dialogiot/Weatherguru/Design files/Com module/NBIoT/Weather Station v2.2-wihtparts.brd

## EAGLE design Design files/Com module/NBIoT/Weather Station v2.2-wihtparts.brd (2019-03-18)

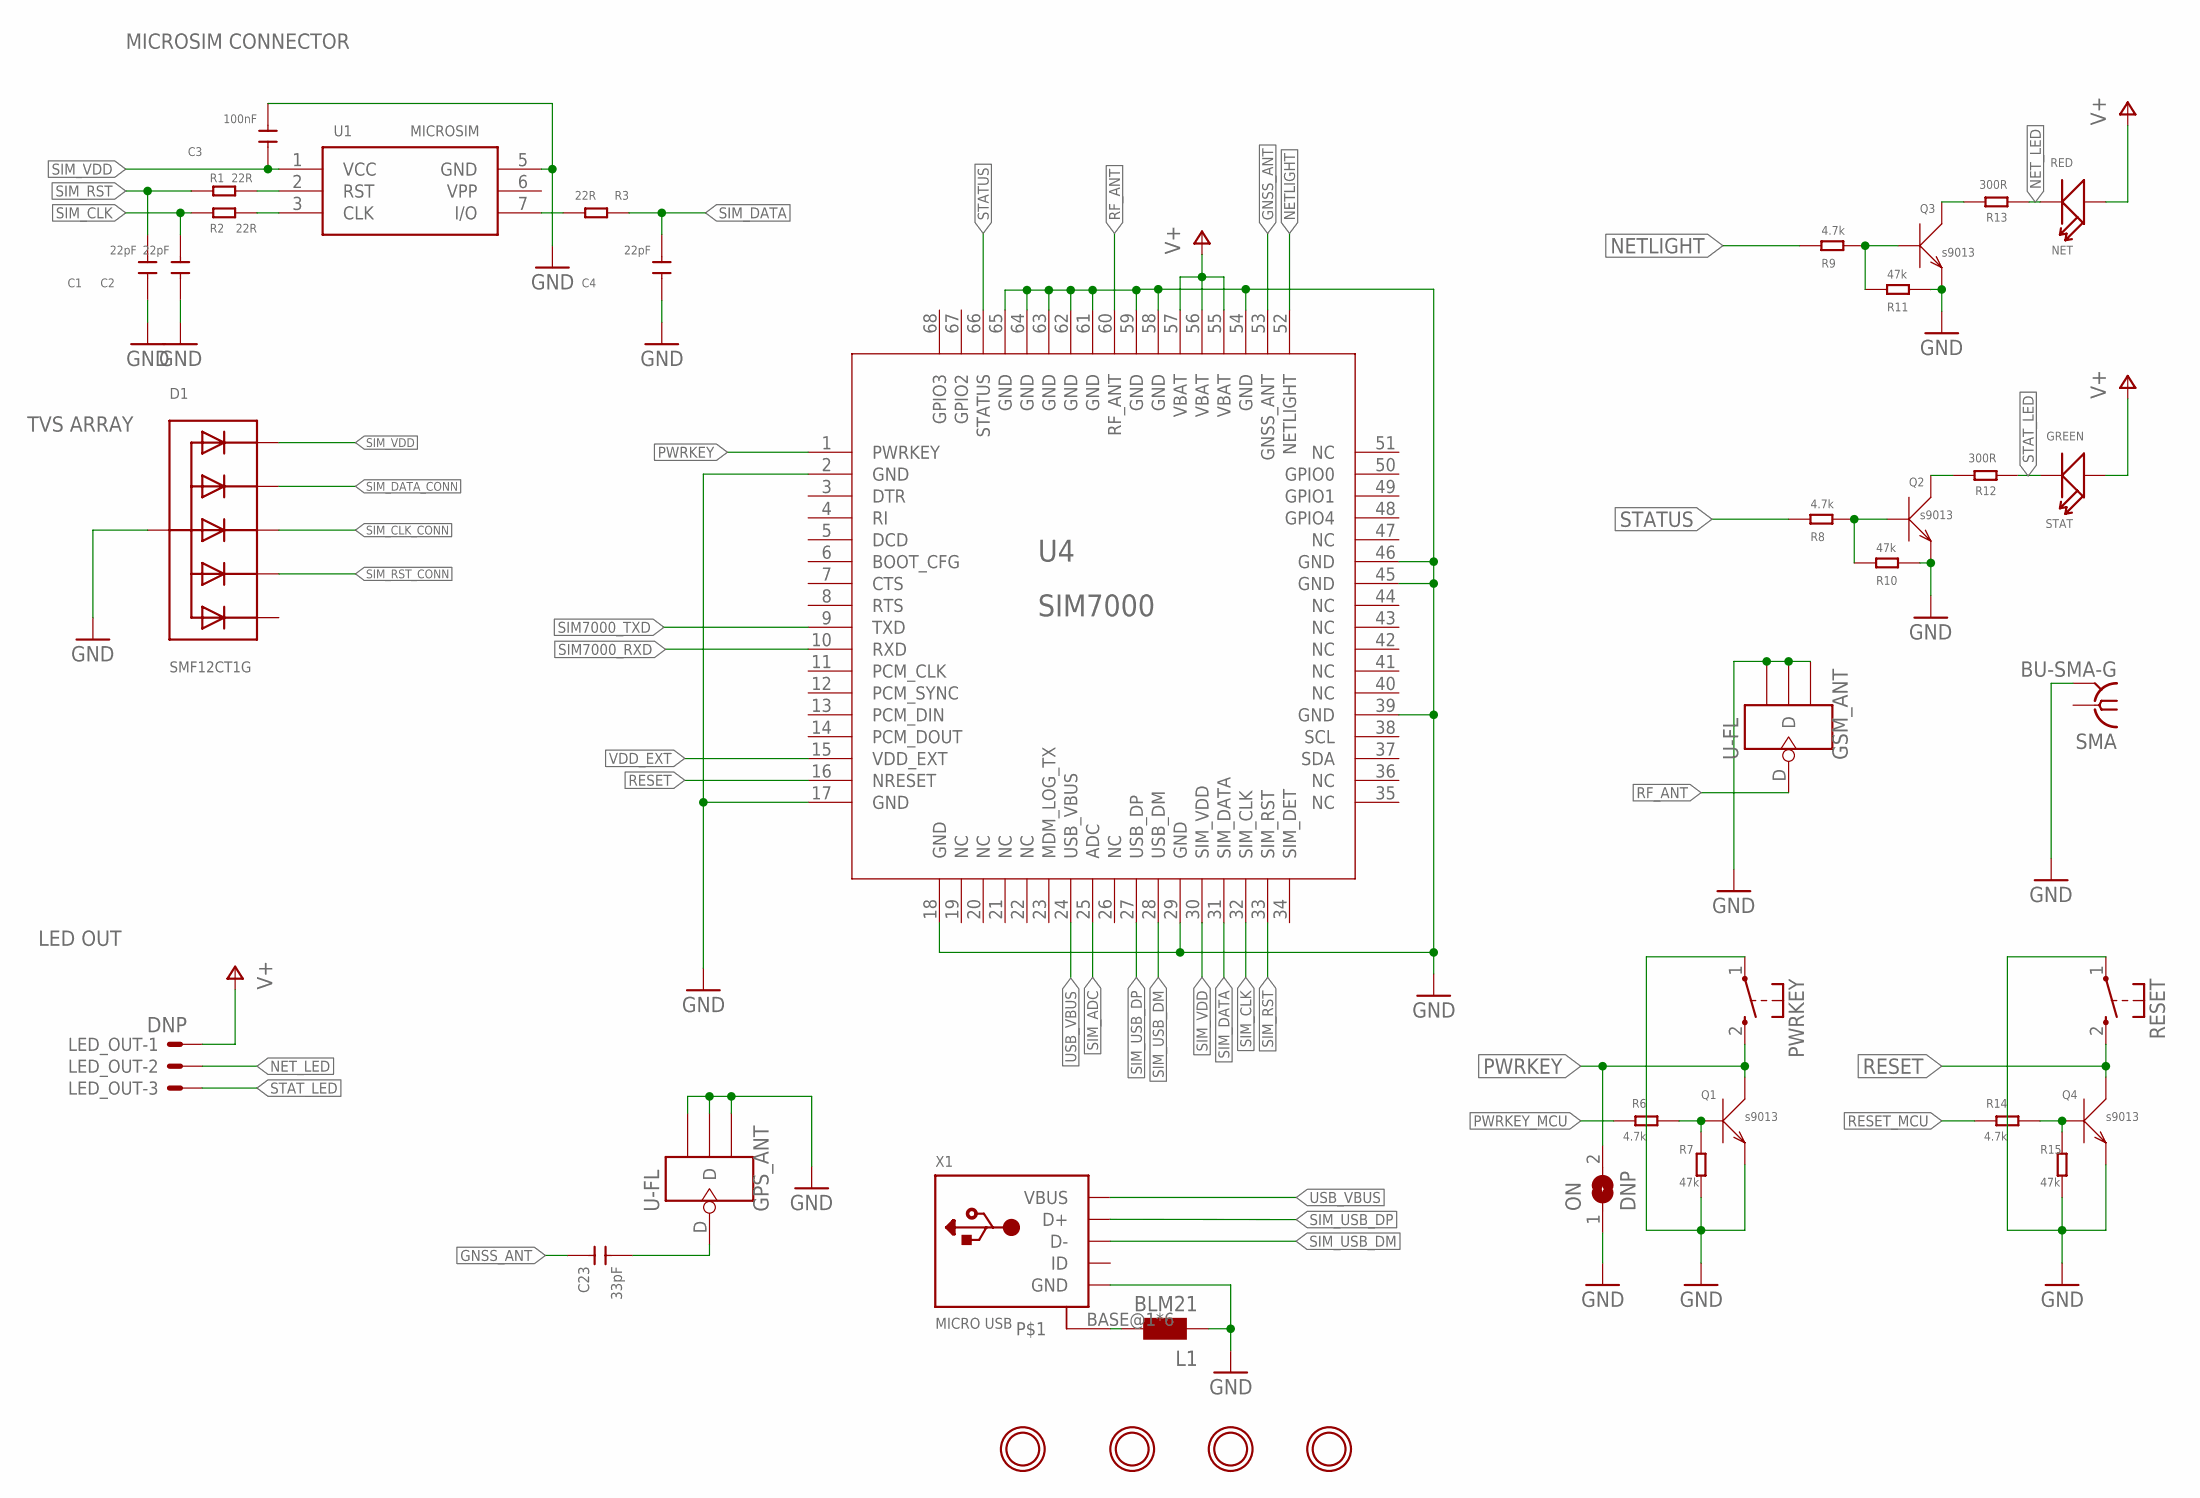
[picture p14: schematic Weather Station v2.2-wihtparts.sch, sheet 1]

Parts:
$H1, $H2, $H3, $H4: DNP; MOUNTINGHOLE_3.0_PLATEDTHIN
C1, C2, C4: 22pF; 0805; MPN C0402C220J5GACTU
C3: 100nF; 0805; MPN 08053G105ZAT2A
C23: 33pF; 0805
D1: SMF12CT1G; SOT363; MPN SMF12CT1G
GPS_ANT: U-FL; 4P-U-FL
GSM_ANT: U-FL; 4P-U-FL; MPN U.FL-R-SMT(01)
L1: BLM21; 0805; MPN BLM21AG121SN1D
LED_OUT: DNP; JST-XH-03-WIRE
NET: RED; LED-2P-2.54-3MM; MPN 5988110107F
ON: DNP; SOLDERJUMPER_REFLOW
PWRKEY: KSS-2EG4430
Q1, Q2, Q3, Q4: s9013; SOT23; MPN DTC143TKAT146.
R1, R2, R3: 22R; 0805; MPN CRM0805-FX-51R0ELF
R6, R8, R9, R14: 4.7k; 0805; MPN MCWF08P4701FTL
R7, R10, R11, R15: 47k; 0805; MPN CRCW080547K0FKEA
R12, R13: 300R; 0805; MPN ERA-6AEB301V
RESET: KSS-2EG4430
SMA: BU-SMA-G; MPN 19-49-5-TGG
STAT: GREEN; LED-2P-2.54-3MM; MPN SML-LX0805SUGC-TR
U1: MICROSIM
U4: SIM7000
X1: MICRO USB; 4UCONN_20329_V2; MPN 10118193-0001LF

Connections:
GND: C1.1, C2.1, C3.2, C4.1, D1.2 (A), GPS_ANT.GND1, GPS_ANT.GND2, GPS_ANT.GND3, GSM_ANT.GND1, GSM_ANT.GND2, GSM_ANT.GND3, L1.1, ON.1, PWRKEY.1, Q1.2 (E), Q2.2 (E), Q3.2 (E), Q4.2 (E), R7.2, R10.2, R11.2, R15.2, RESET.1, SMA.2, SMA.3 (2), SMA.4 (2), SMA.5 (2), U1.5 (GND), U4.2 (GND), U4.17 (GND), U4.18 (GND), U4.29 (GND), U4.39 (GND), U4.45 (GND), U4.46 (GND), U4.54 (GND), U4.58 (GND), U4.59 (GND), U4.61 (GND), U4.62 (GND), U4.63 (GND), U4.64 (GND), U4.65 (GND), X1.GND; also elsewhere on the board
GNSS_ANT: C23.2, U4.53 (GNSS_ANT)
GPIO2: U4.67 (GPIO2)
GPIO3: U4.68 (GPIO3)
unnamed: Q4.1 (B), R14.2, R15.1
unnamed: Q2.3 (C), R12.2
unnamed: Q2.1 (B), R8.2, R10.1
unnamed: Q3.3 (C), R13.2
unnamed: Q3.1 (B), R9.2, R11.1
unnamed: C23.1, GPS_ANT.D
unnamed: L1.2, X1.BASE@1, X1.BASE@2, X1.SPRT@1, X1.SPRT@2, X1.SPRT@3, X1.SPRT@4
unnamed: Q1.1 (B), R6.2, R7.1
NETLIGHT: R9.1, U4.52 (NETLIGHT)
NET_LED: LED_OUT.2, NET.K (-), R13.1
PWRKEY: ON.2, PWRKEY.2 (S), Q1.3 (C), U4.1 (PWRKEY)
PWRKEY_MCU: R6.1; also elsewhere on the board
RESET: Q4.3 (C), RESET.2 (S), U4.16 (NRESET)
RESET_MCU: R14.1; also elsewhere on the board
RF_ANT: GSM_ANT.D, U4.60 (RF_ANT)
SIM7000_RXD: U4.10 (RXD); also elsewhere on the board
SIM7000_TXD: U4.9 (TXD); also elsewhere on the board
SIM_ADC: U4.25 (ADC)
SIM_CLK: C2.2, R2.2, U4.32 (SIM_CLK)
SIM_CLK_CONN: D1.4 (C3), R2.1, U1.3 (CLK)
SIM_DATA: C4.2, R3.1, U4.31 (SIM_DATA)
SIM_DATA_CONN: D1.3 (C2), R3.2, U1.7 (I/O)
SIM_RST: C1.2, R1.2, U4.33 (SIM_RST)
SIM_RST_CONN: D1.5 (C4), R1.1, U1.2 (RST)
SIM_USB_DM: U4.28 (USB_DM), X1.D-
SIM_USB_DP: U4.27 (USB_DP), X1.D+
SIM_VDD: C3.1, D1.1 (C1), U1.1 (VCC), U4.30 (SIM_VDD)
STATUS: R8.1, U4.66 (STATUS)
STAT_LED: LED_OUT.3, R12.1, STAT.K (-)
USB_VBUS: U4.24 (USB_VBUS), X1.VBUS
V+: LED_OUT.1, NET.A (+), STAT.A (+), U4.55 (VBAT), U4.56 (VBAT), U4.57 (VBAT); also elsewhere on the board
VDD_EXT: U4.15 (VDD_EXT); also elsewhere on the board

Notes on the sheet:
TVS ARRAY
MICROSIM CONNECTOR
LED OUT

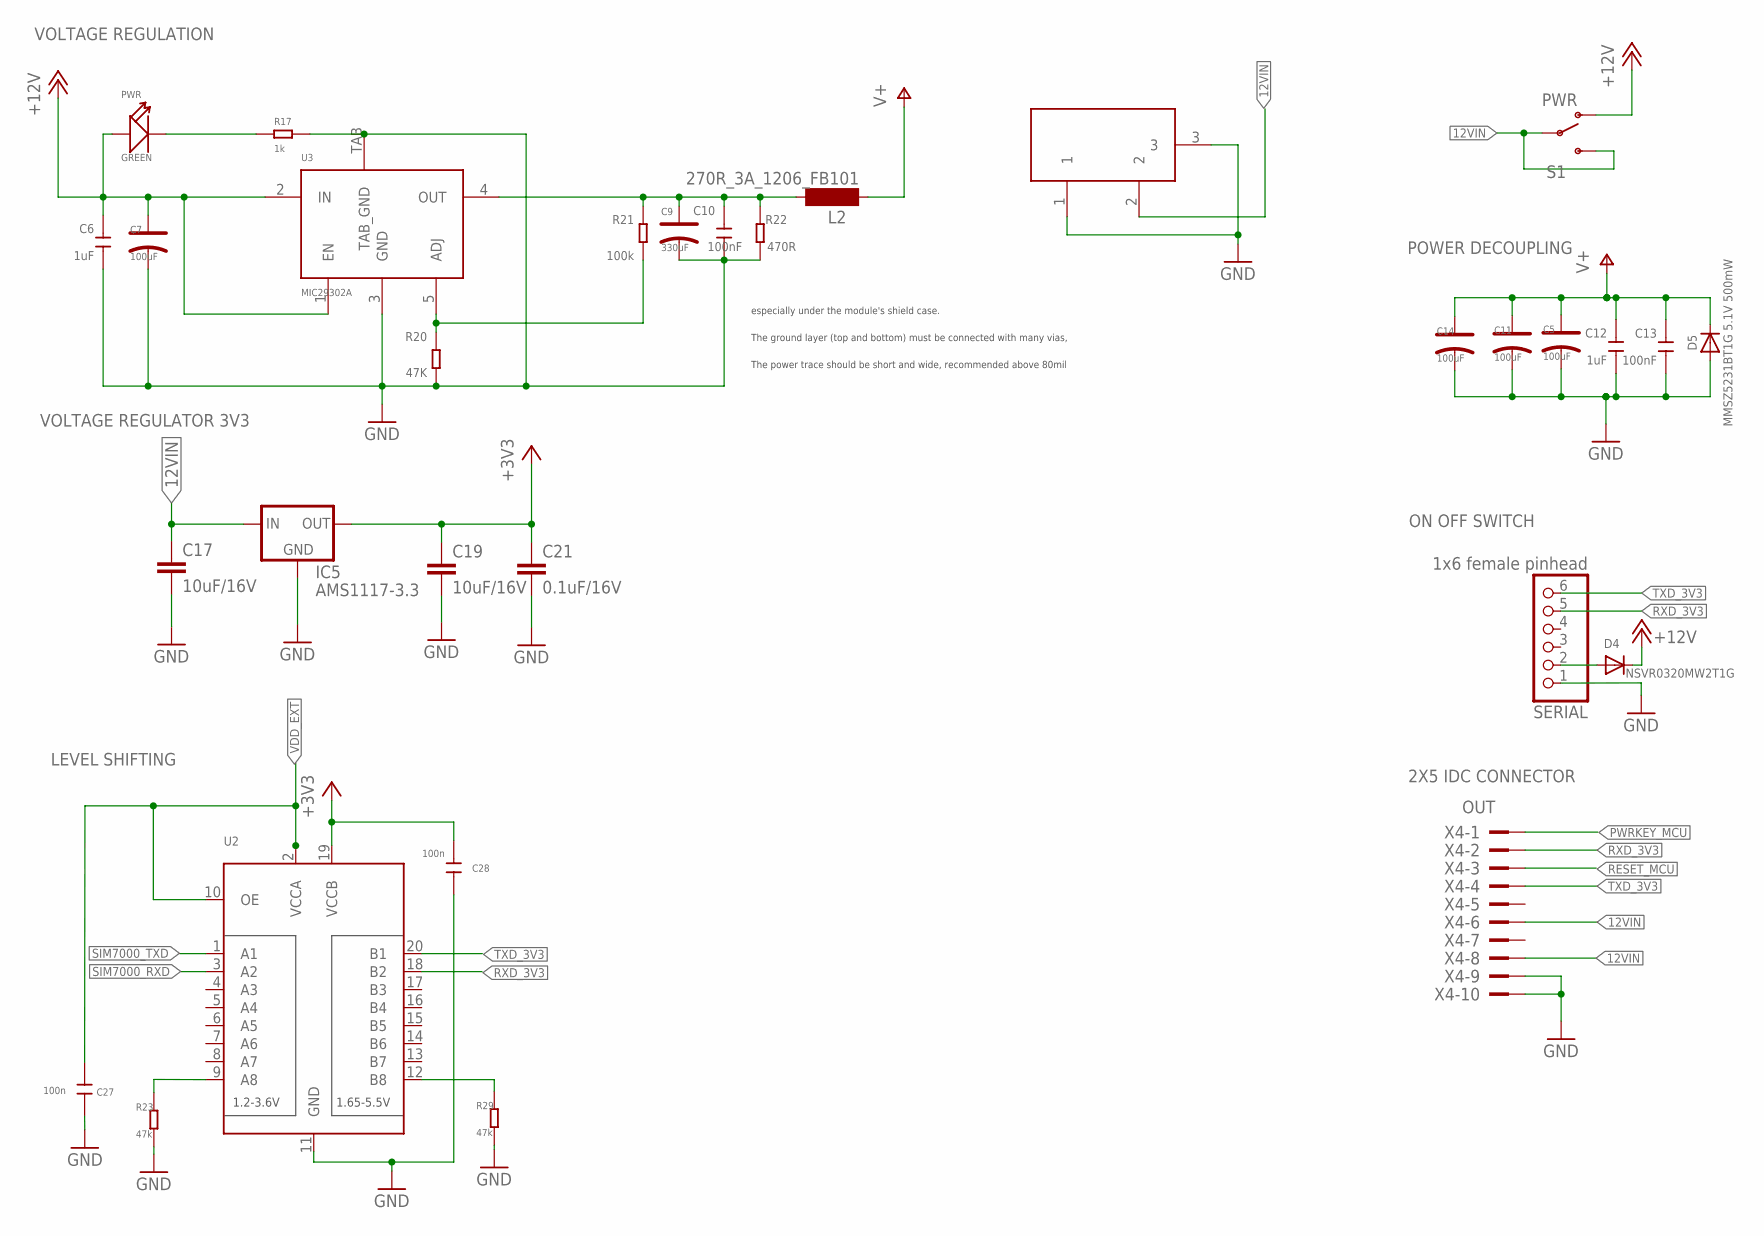
[picture p15: schematic Weather Station v2.2-wihtparts.sch, sheet 2]

Parts:
C5, C7, C11, C14: 100uF; AVX_D; MPN TCJD107M025R0055
C6: 1uF; 0805; MPN 08053G105ZAT2A
C8: DC21MMX; DC-21MM; MPN FC681478
C9: 330uF; AVX_D; MPN TCJE337M016R0050
C10: 100nF; 0805; MPN MC0805B104M160CT
C12: 1uF; 0805; MPN GRM21BF51C106ZE15L
C13: 100nF; 0805; MPN 08055A330JAT2A
C17, C19: 10uF/16V; C0805K
C21: 0.1uF/16V; C0805K
C27, C28: 100n; 0805
D4: NSVR0320MW2T1G; SOD-323; MPN NSVR0320MW2T1G
D5: MMSZ5231BT1G 5.1V 500mW; SOD-123; MPN MMSZ5231BT1G
IC5: AMS1117-3.3; SOT223
L2: 270R_3A_1206_FB101; SM-1206; MPN 742792121
PWR: GREEN; D0805; MPN SML-LX0805SUGC-TR
R17: 1k; 0805; MPN CRCW08051K00FKTA
R20: 47K; 0805; MPN CRCW080543K0JNEA.
R21: 100k; 0805; MPN CRCW0805100KJNEA
R22: 470R; 0805; MPN ERA-6AEB471V
R23, R29: 47k; 0805
S1: PWR; SWITCH-SPDT-CUSTOM; MPN EG1201
SERIAL: 1x6 female pinhead; 1X06
U2: TXB0108PWR; TSSOP20
U3: MIC29302A; TO-263A; MPN MIC29302WU-TR
X4: OUT; PAK100/2500-10; MPN 30310-6002HB

Connections:
12VIN: C8.2, C17.1, IC5.3 (IN), S1.2, S1.3 (S), X4.6, X4.8
+3V3: C19.1, C21.1, C28.2, IC5.2 (OUT), U2.19 (VCCB)
+12V: C6.2, C7.+, D4.C, PWR.+, S1.1 (O), U3.1 (EN), U3.2 (IN)
GND: C5.-, C6.1, C7.-, C8.1, C8.3, C9.-, C10.1, C11.-, C12.1, C13.1, C14.-, C17.2, C19.2, C21.2, C27.1, C28.1, D5.A, IC5.1 (GND), R17.2, R20.1, R22.1, R23.2, R29.2, SERIAL.1, U2.11 (GND), U3.3 (GND), U3.TAB (TAB_GND), X4.9, X4.10; also elsewhere on the board
unnamed: R20.2, R21.1, U3.5 (ADJ)
unnamed: R23.1, U2.9 (A8)
unnamed: D4.A, SERIAL.2
unnamed: R29.1, U2.12 (B8)
unnamed: PWR.-, R17.1
PWRKEY_MCU: X4.1; also elsewhere on the board
RESET_MCU: X4.3; also elsewhere on the board
RXD_3V3: SERIAL.5, U2.18 (B2), X4.2
SIM7000_RXD: U2.3 (A2); also elsewhere on the board
SIM7000_TXD: U2.1 (A1); also elsewhere on the board
TXD_3V3: SERIAL.6, U2.20 (B1), X4.4
V+: C5.+, C11.+, C12.2, C13.2, C14.+, D5.C, L2.1; also elsewhere on the board
VDD_EXT: C27.2, U2.2 (VCCA), U2.10 (OE); also elsewhere on the board
VOUT: C9.+, C10.2, L2.2, R21.2, R22.2, U3.4 (OUT)

Notes on the sheet:
The power trace should be short and wide, recommended above 80mil
The ground layer (top and bottom) must be connected with many vias,
especially under the module's shield case.
VOLTAGE REGULATION
ON OFF SWITCH
POWER DECOUPLING
LEVEL SHIFTING
2X5 IDC CONNECTOR
VOLTAGE REGULATOR 3V3

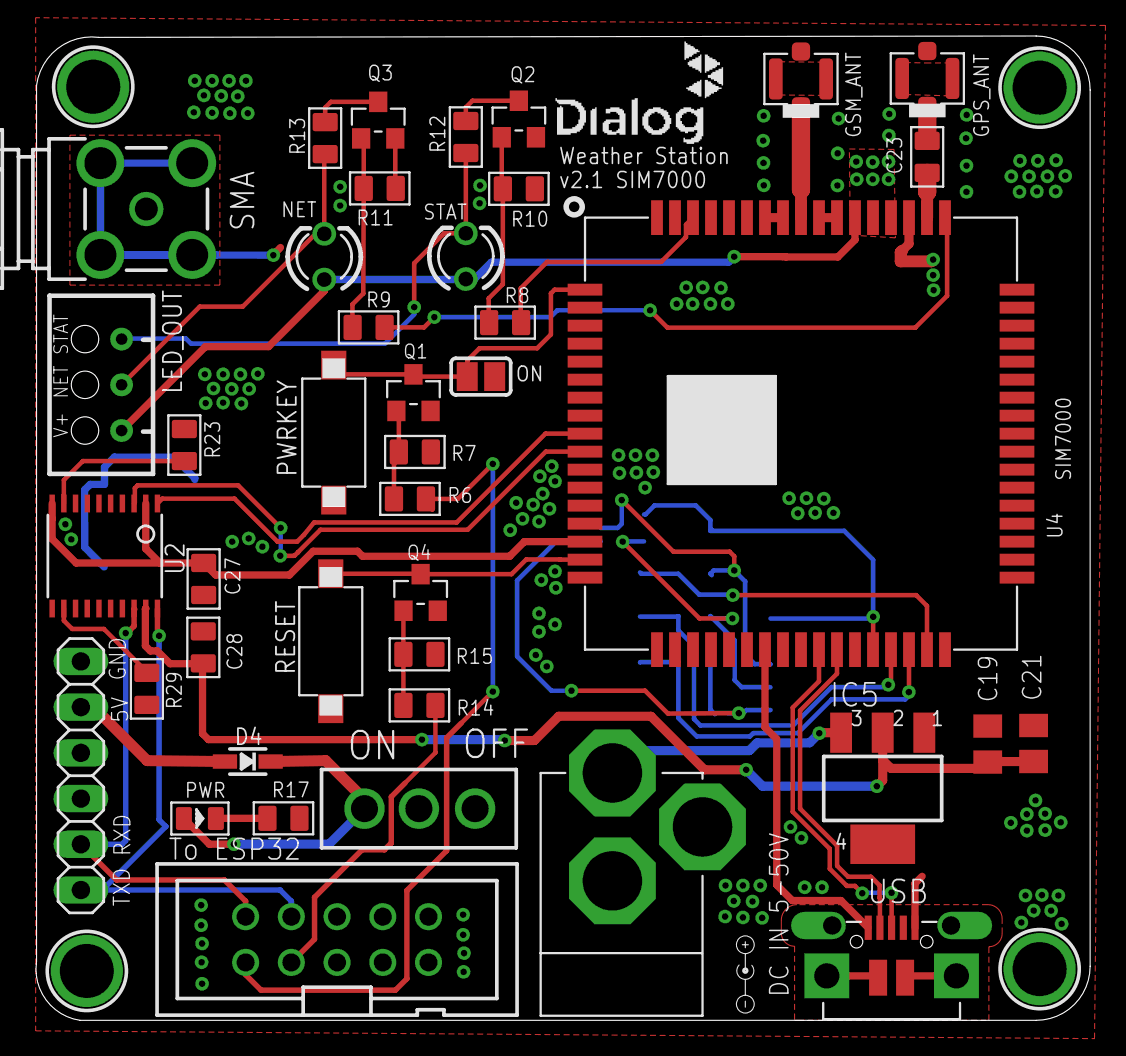
[picture p16: board Weather Station v2.2-wihtparts.brd from above]

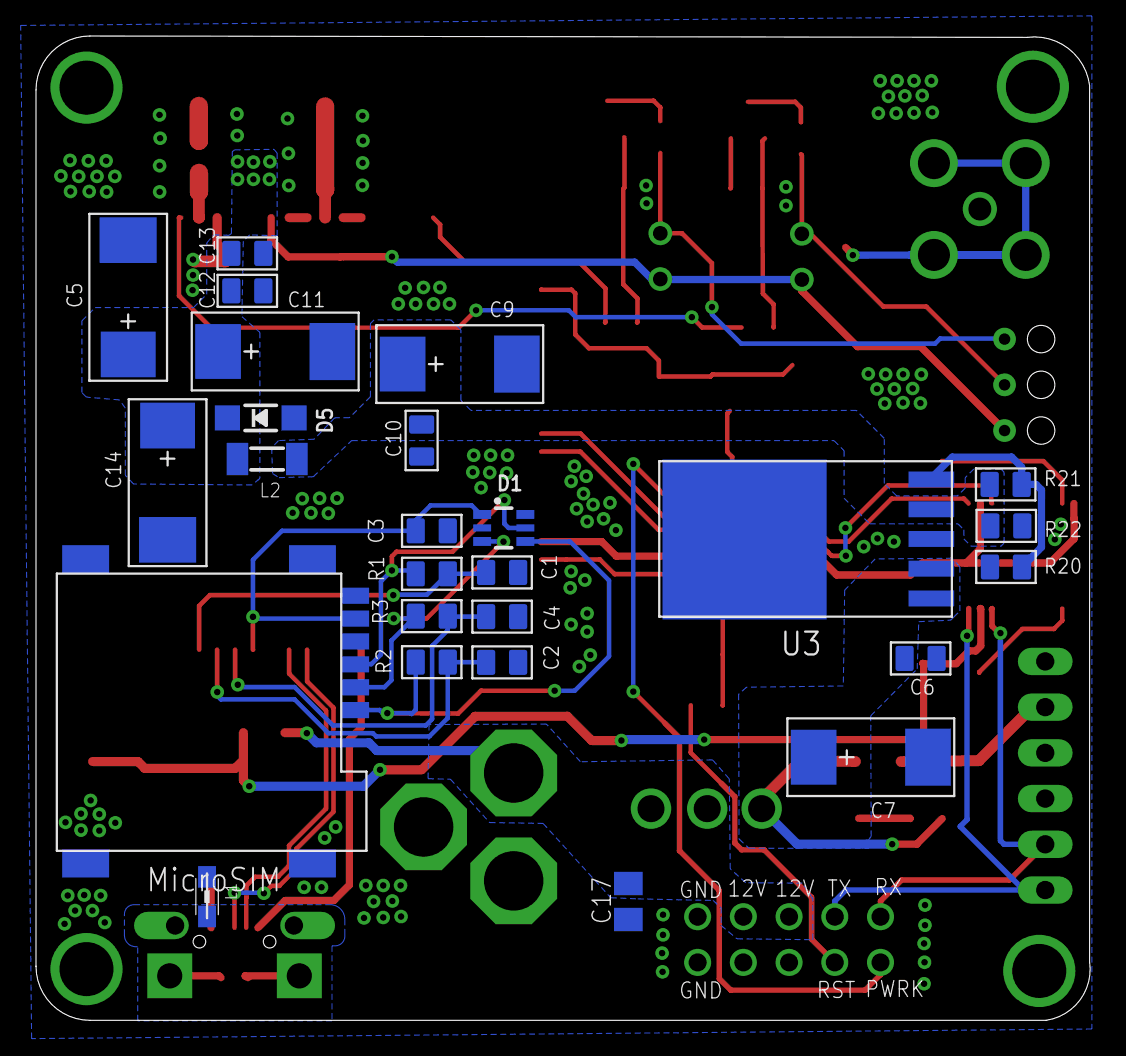
[picture p17: board Weather Station v2.2-wihtparts.brd from below]

Board: 2 copper layers, 58.6 x 54.7 mm, 71 parts (26 on the bottom side), 44 nets.
