dialogiot/Weatherguru/Design files/Com module/GSM/SIM900_schematic.brd

## EAGLE design Design files/Com module/GSM/SIM900_schematic.brd (2019-03-18)

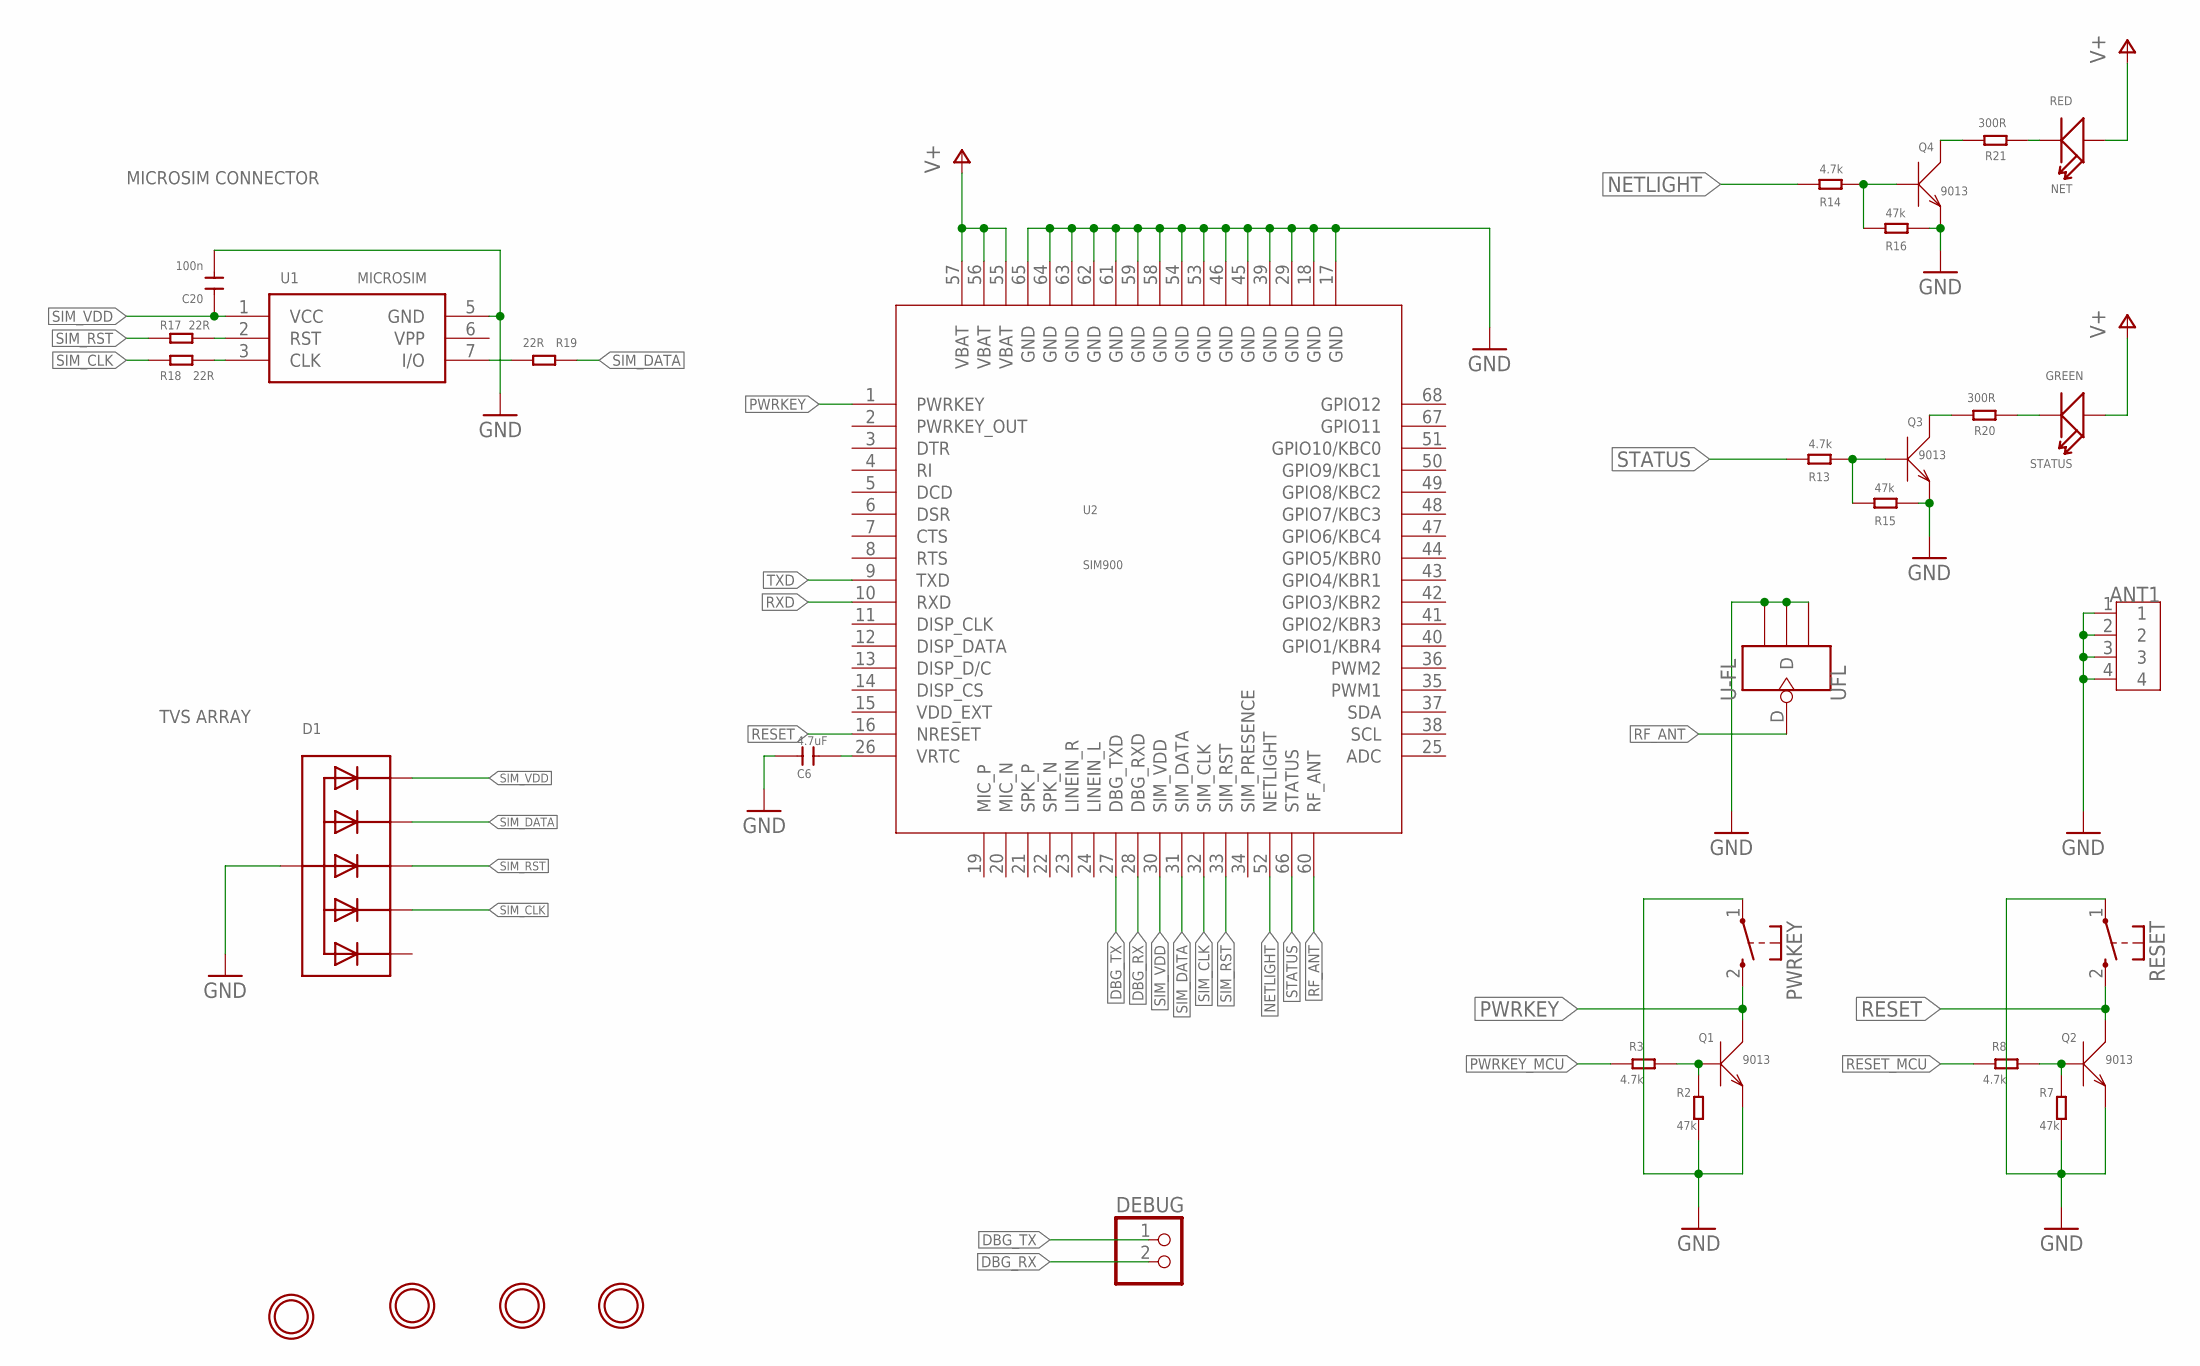
[picture p18: schematic SIM900_schematic.sch, sheet 1]

Parts:
ANT1: ANTENNA-SMA-IPX; SMA-TO-IPX
C6: 4.7uF; 0805
C20: 100n; 0805
D1: TVSARRAY_5LANE; SOT363
DEBUG: PINHD-1X2; 1X02
NET: RED; LED-0805
PWRKEY: KSS-2EG4430
Q1, Q2, Q3, Q4: 9013; SOT23
R2, R7, R15, R16: 47k; 0805
R3, R8, R13, R14: 4.7k; 0805
R17, R18, R19: 22R; 0805
R20, R21: 300R; 0805
RESET: KSS-2EG4430
STATUS: GREEN; LED-0805
U1: MICROSIM
U2: SIM900
U$1, U$2, U$3, U$4: MOUNTINGHOLE3.0THIN; MOUNTINGHOLE_3.0_PLATEDTHIN
UFL: U-FL; 4P-U-FL

Connections:
DBG_RX: DEBUG.2, U2.28 (DBG_RXD)
DBG_TX: DEBUG.1, U2.27 (DBG_TXD)
GND: ANT1.1, ANT1.2, ANT1.3, ANT1.4, C6.1, C20.2, D1.2 (A), PWRKEY.1, Q1.2 (E), Q2.2 (E), Q3.2 (E), Q4.2 (E), R2.2, R7.2, R15.2, R16.2, RESET.1, U1.5 (GND), U2.17 (GND), U2.18 (GND), U2.29 (GND), U2.39 (GND), U2.45 (GND), U2.46 (GND), U2.53 (GND), U2.54 (GND), U2.58 (GND), U2.59 (GND), U2.61 (GND), U2.62 (GND), U2.63 (GND), U2.64 (GND), U2.65 (GND), UFL.GND1, UFL.GND2, UFL.GND3; also elsewhere on the board
unnamed: Q2.1 (B), R7.1, R8.2
unnamed: Q3.3 (C), R20.2
unnamed: R19.2, U1.7 (I/O)
unnamed: R18.1, U1.3 (CLK)
unnamed: R17.1, U1.2 (RST)
unnamed: R20.1, STATUS.-
unnamed: Q3.1 (B), R13.2, R15.1
unnamed: Q4.3 (C), R21.2
unnamed: NET.-, R21.1
unnamed: Q4.1 (B), R14.2, R16.1
unnamed: Q1.1 (B), R2.1, R3.2
NETLIGHT: R14.1, U2.52 (NETLIGHT)
PWRKEY: PWRKEY.2 (S), Q1.3 (C), U2.1 (PWRKEY)
PWRKEY_MCU: R3.1; also elsewhere on the board
RESET: Q2.3 (C), RESET.2 (S), U2.16 (NRESET)
RESET_MCU: R8.1; also elsewhere on the board
RF_ANT: U2.60 (RF_ANT), UFL.D
RXD: U2.10 (RXD); also elsewhere on the board
SIM_CLK: D1.5 (C4), R18.2, U2.32 (SIM_CLK)
SIM_DATA: D1.3 (C2), R19.1, U2.31 (SIM_DATA)
SIM_RST: D1.4 (C3), R17.2, U2.33 (SIM_RST)
SIM_VDD: C20.1, D1.1 (C1), U1.1 (VCC), U2.30 (SIM_VDD)
STATUS: R13.1, U2.66 (STATUS)
TXD: U2.9 (TXD); also elsewhere on the board
V+: NET.+, STATUS.+, U2.55 (VBAT), U2.56 (VBAT), U2.57 (VBAT); also elsewhere on the board
VRTC: C6.2, U2.26 (VRTC)

Notes on the sheet:
TVS ARRAY
MICROSIM CONNECTOR

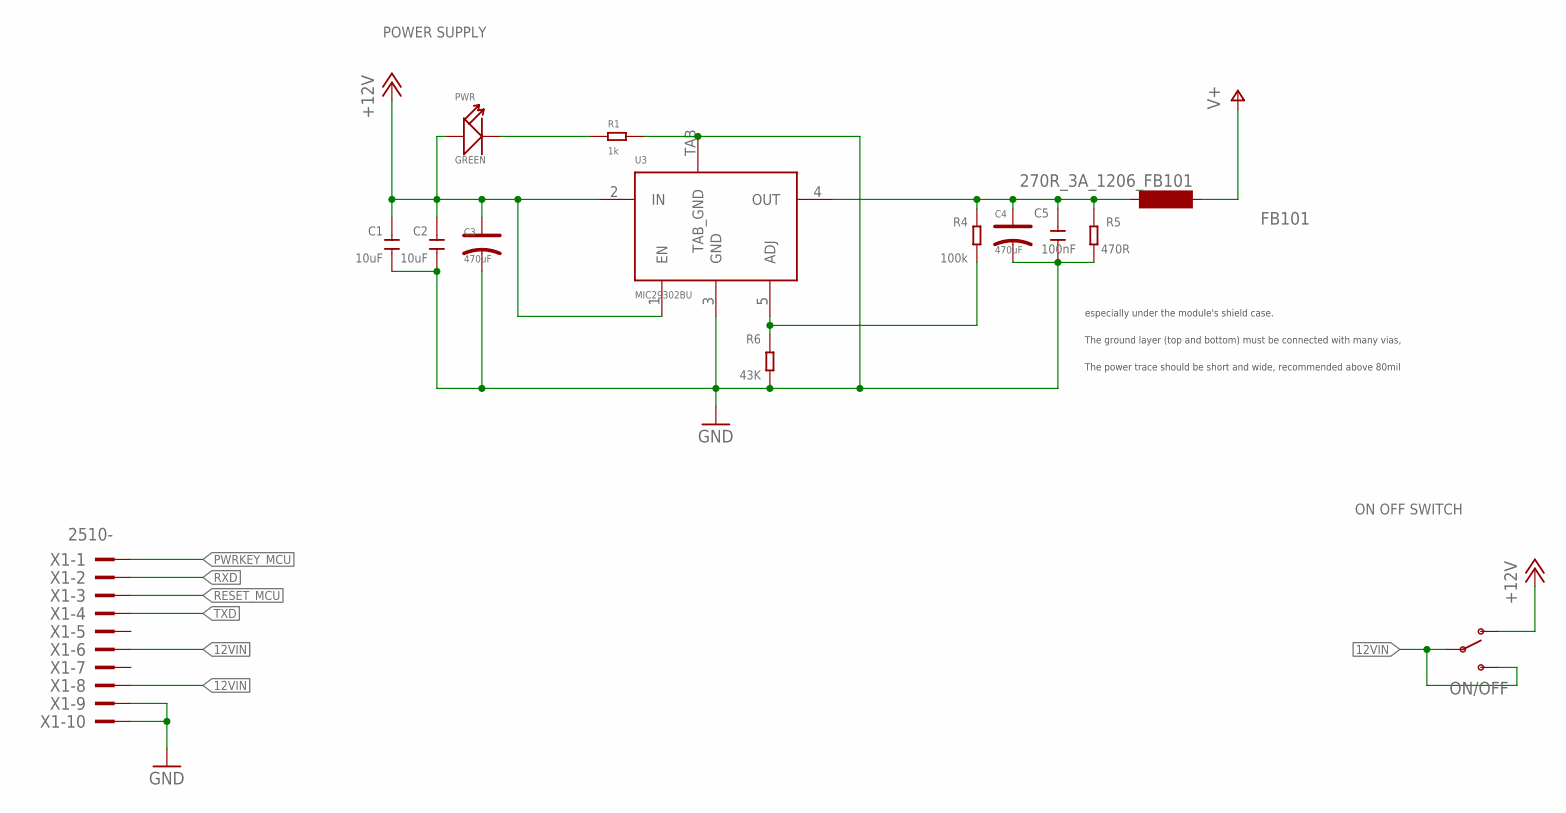
[picture p19: schematic SIM900_schematic.sch, sheet 2]

Parts:
C1, C2: 10uF; 0805
C3, C4: 470uF; AVX_D
C5: 100nF; 0805
FB101: 270R_3A_1206_FB101; SM-1206
ON/OFF: SWITCH-SPDTPTH; SWITCH-SPDT
PWR: GREEN; D0805
R1: 1k; 0805
R4: 100k; 0805
R5: 470R; 0805
R6: 43K; 0805
U3: MIC29302BU; TO-263
X1: 2510-; PAK100/2500-10

Connections:
12VIN: ON/OFF.2, ON/OFF.3 (S), X1.6, X1.8
+12V: C1.2, C2.2, C3.+, ON/OFF.1 (O), PWR.+, U3.1 (EN), U3.2 (IN)
GND: C1.1, C2.1, C3.-, C4.-, C5.1, R1.2, R5.1, R6.1, U3.3 (GND), U3.TAB (TAB_GND), X1.9, X1.10; also elsewhere on the board
unnamed: R4.1, R6.2, U3.5 (ADJ)
unnamed: PWR.-, R1.1
PWRKEY_MCU: X1.1; also elsewhere on the board
RESET_MCU: X1.3; also elsewhere on the board
RXD: X1.2; also elsewhere on the board
TXD: X1.4; also elsewhere on the board
V+: FB101.1; also elsewhere on the board
VOUT: C4.+, C5.2, FB101.2, R4.2, R5.2, U3.4 (OUT)

Notes on the sheet:
The power trace should be short and wide, recommended above 80mil
The ground layer (top and bottom) must be connected with many vias,
especially under the module's shield case.
POWER SUPPLY
ON OFF SWITCH

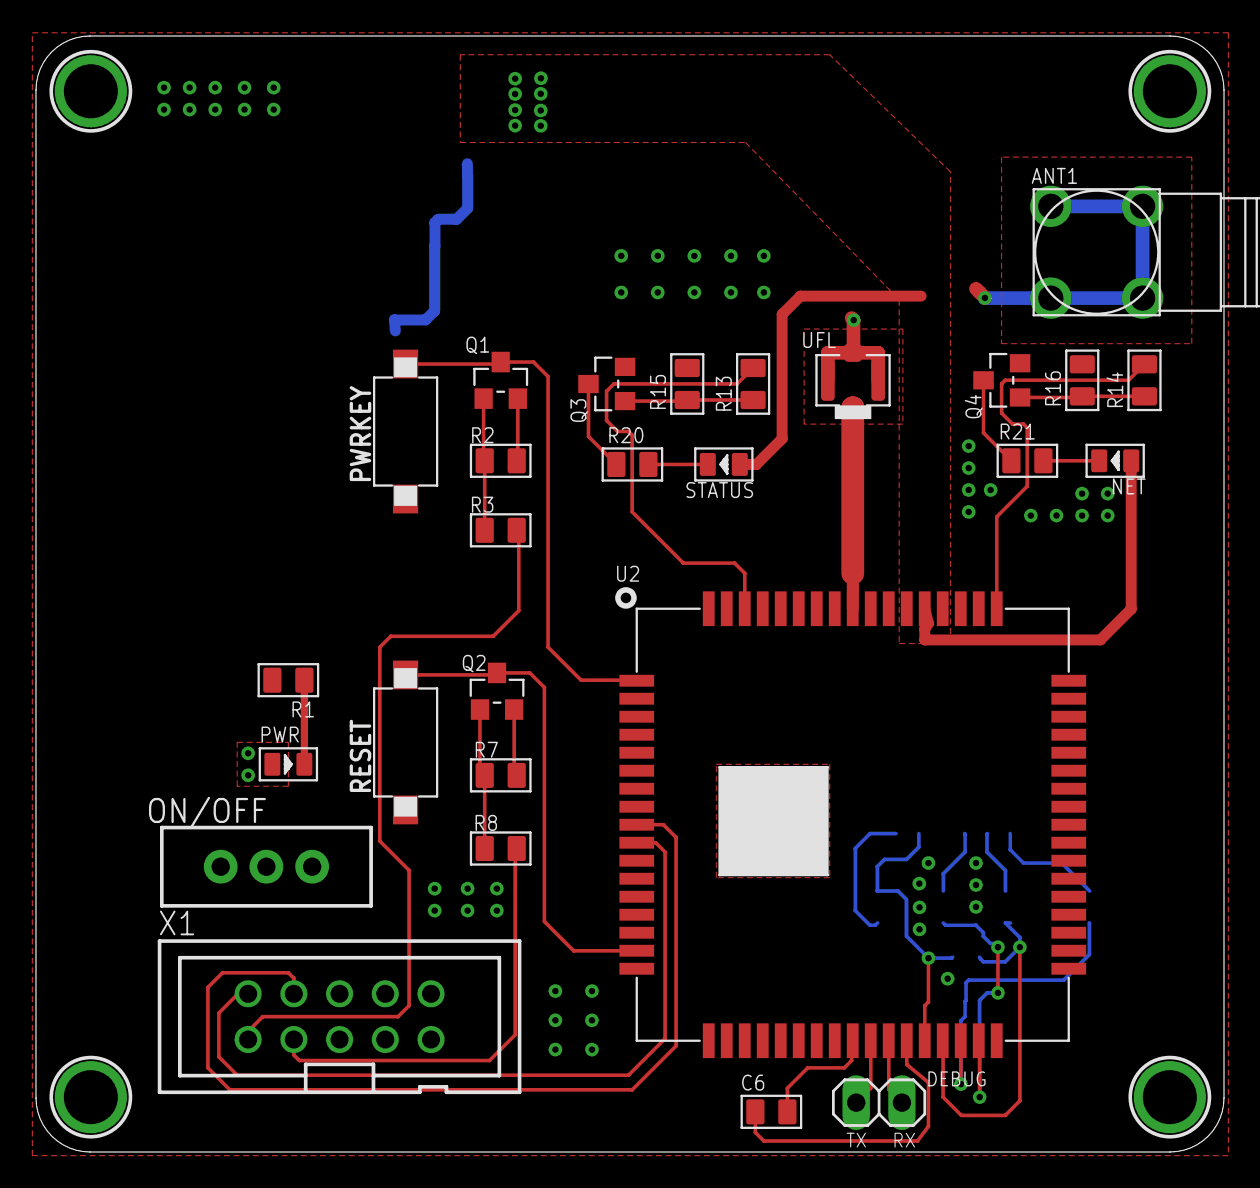
[picture p20: board SIM900_schematic.brd from above]

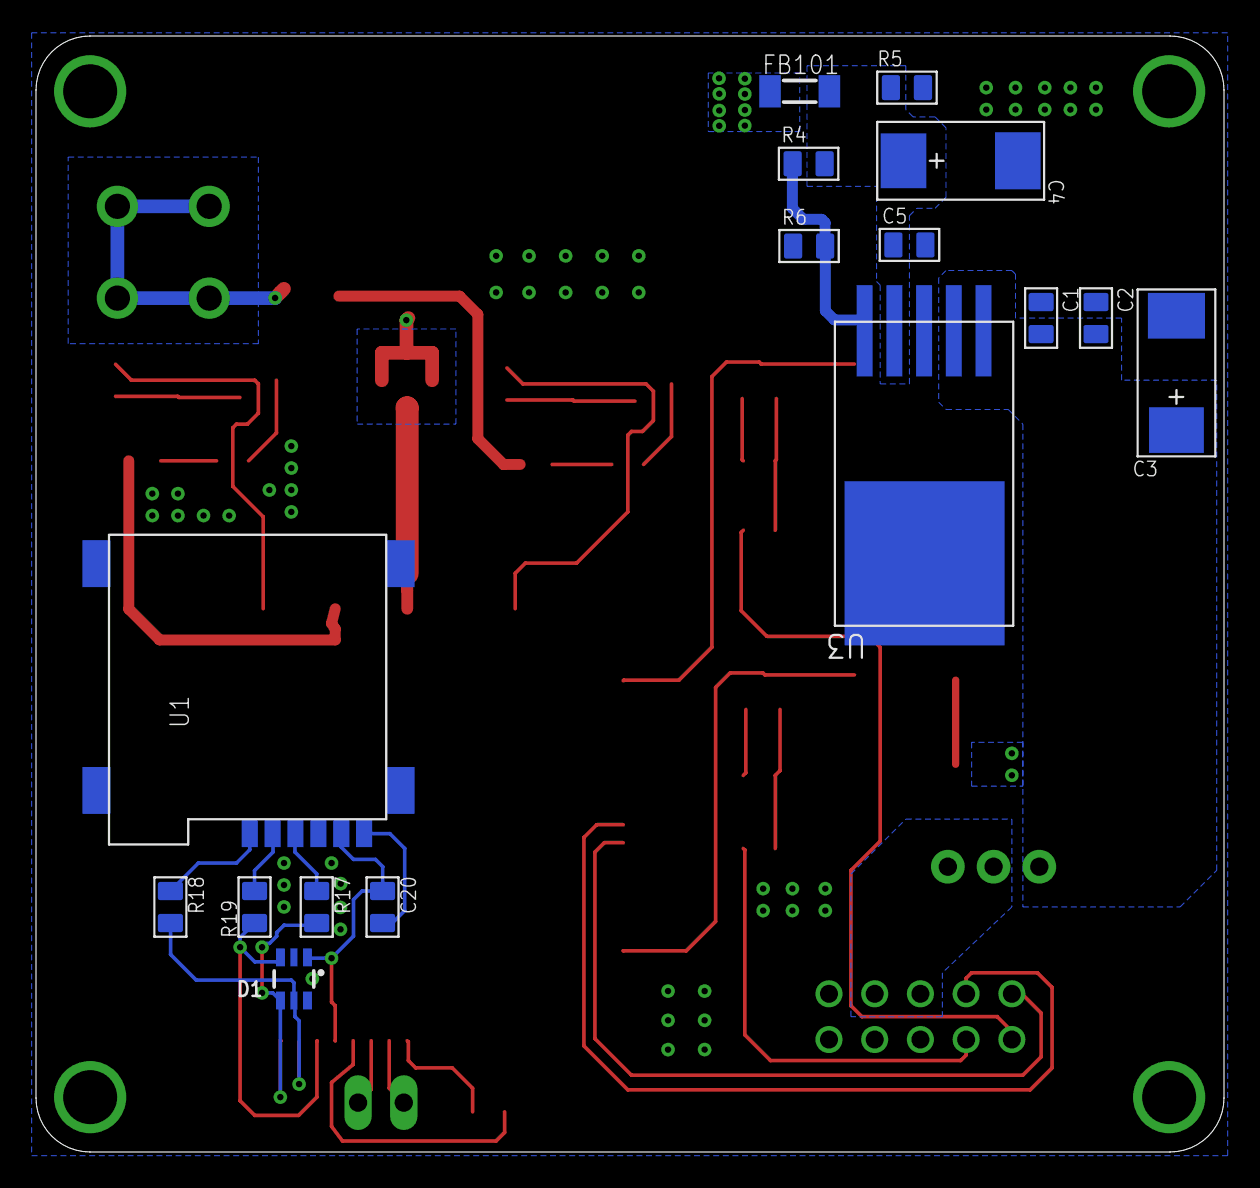
[picture p21: board SIM900_schematic.brd from below]

Board: 2 copper layers, 66.0 x 62.0 mm, 47 parts (16 on the bottom side), 34 nets.
