dialogiot/Weatherguru/(commit log)

2019-03-18 3/18/2019
    Commit
    [SIM900_schematic.brd]
2019-03-18 18/3/2019
    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
    [SIM900_schematic.sch, Weather Station v2.2-wihtparts.brd, Weather Station v2.2-wihtparts.sch]
